saulorios/drone-neuromorfico/docs/caderno.md

# Caderno: decisões, descartes e coisas aprendidas

O `decisoes.md` registra *o que* mudou e *quando*. Este caderno é para o raciocínio mais
longo: alternativas consideradas e por que foram descartadas, intuições que se mostraram
erradas, e perguntas ainda em aberto.

---

## Intuições que se mostraram erradas

### "O capacitor de membrana define a constante de tempo do neurônio"

Falso nesta topologia, e a razão é bonita. Numa membrana biológica, ou num
integrador RC comum, aumentar a capacitância aumenta a constante de tempo. Aqui não.

A membrana precisa percorrer uma janela de histerese `ΔV` que é criada pelo próprio
degrau de realimentação através de `Cfb`. Esse degrau é um divisor capacitivo:
`ΔV = VDD · Cfb / (Cmem + Cfb + parasitas)`. A rampa, por sua vez, sobe a
`Iin / (Cmem + Cfb + parasitas)`.

O tempo de percurso é `ΔV` dividido pela inclinação — e o mesmo `Ctot` aparece no
numerador e no denominador:

```
T = Ctot · ΔV / Iin = Ctot · (VDD · Cfb / Ctot) / Iin = Cfb · VDD / Iin
```

`Cmem` desaparece. Não "quase se cancela": some. Quem manda na frequência é `Cfb`,
`VDD` e `Iin`.

A intuição errada tinha uma consequência de projeto errada junto: supunha-se que o
capacitor de membrana dominaria a área do neurônio no chip. Como ele deve ser pequeno,
a estimativa de área está invertida — o neurônio pode ser mais compacto que o previsto.

**O que `Cmem` de fato controla** é a excursão de sinal, e para pior: 25 fF dá 1,05 V de
excursão, 400 fF dá 0,079 V. Abaixo de ~0,2 V, descasamento entre transistores e ruído
de alimentação passam a dominar o comportamento. `Cmem` grande não compra lentidão;
compra fragilidade.

---

## Alternativas consideradas e descartadas

### Chips especializados por modalidade (um para áudio, outro para visão)

Descartado. Três motivos: (a) o gargalo real do sistema é a comunicação entre chips, e
separar modalidades encarece justamente as associações multissensoriais que se quer ter;
(b) a proporção necessária entre modalidades ainda é desconhecida, e chips fixos travam
essa proporção antes da hora; (c) três máscaras custam três vezes mais que uma.

Escolha adotada: um único chip com neurônios configuráveis por tensões de polarização,
replicado quantas vezes couber no orçamento de peso e energia. A modalidade vira
parâmetro de configuração, não silício. É a mesma escolha feita por Loihi, SpiNNaker e
Akida — o que é um bom sinal, mas não é prova.

Exceção legítima: a interface analógica de sensor (amplificador de microfone,
fotodiodos) é específica por modalidade e não configurável. Vai num chip de interface
pequeno e barato, separado do chip de neurônios homogêneo.

### Re-rodar a etapa 0 com nível 1 para refazer os números de física

Descartado em 2026-09-06. Os modelos nível 1 não descrevem a condução sub-limiar, então
qualquer número refeito com eles teria que ser refeito de novo na etapa 1.

Mas um re-rodar *de numérica* foi mantido: ver a pergunta em aberto sobre `abstol`
abaixo. Ele custa minutos, testa a ferramenta em vez do circuito, e as ressalvas 1 a 3
podem ser artefato de tolerância, não de física.

---

## Perguntas em aberto

- **De onde vem o fator 1,76×?** O modelo `T = Cfb·VDD/Iin` prevê 278 Hz em 10 pA;
  mediu-se 158 Hz. O modelo acerta *todas* as tendências — independência de `Cmem`,
  linearidade em `Iin`, escala com VDD dentro de 3% — e erra só a escala absoluta, o que
  aponta para um fator multiplicativo constante e não para um mecanismo faltando.
  Suspeita: a saída ultrapassa VDD no spike (visível no painel 1, ~1,9 V contra 1,8 V de
  alimentação) e o reset leva a membrana abaixo do ponto de equilíbrio; juntos, alargam
  a janela de histerese real além de `VDD · Cfb / Ctot`. Verificável medindo a janela
  diretamente em vez de inferi-la.

- **A curva f–I é mesmo linear?** Nunca foi testada — o R² era uma string. Com o
  intercepto observado, a reta prevê 181 Hz em 10 pA contra 158 Hz medidos. Ou há
  curvatura real, ou é o ruído numérico de ~10% do item 1 das ressalvas. Os dois casos
  têm consequências diferentes e precisam ser separados.

- **Quanto da frequência é rampa e quanto é reset?** Se o tempo de reset for uma fração
  grande do período, ele impõe um teto de frequência que a curva f–I ainda não alcançou,
  e a linearidade vai quebrar em correntes mais altas que 100 pA.

- **A dependência `f ∝ VDD` é fatal?** Ela é estrutural, não um ajuste ruim: sai direto
  da equação. Se a compensação exigir mudar a topologia (limitar a excursão de saída em
  vez de deixá-la ir de trilho a trilho), é melhor descobrir na etapa 1 do que na 8.

- **As ressalvas da etapa 0 são física ou são `abstol`?** O padrão do ngspice é
  `abstol = 1 pA`, e as simulações rodaram com `Iin` de 1 a 100 pA sem nenhum `.options`.
  No ponto de 1 pA, o sinal inteiro está dentro da tolerância de convergência; no ponto
  nominal de 10 pA, a tolerância é 10% do sinal — a mesma ordem do espalhamento
  observado entre execuções. O `gmin` padrão (1e-12 S) acrescenta mais ~0,9 pA de fuga
  parasita no nó `mem`. É uma explicação única e econômica para as ressalvas 1, 2 e 3,
  e é barata de testar. Enquanto não for testada, continua sendo hipótese: pode ser que
  o espalhamento venha só de `tstep` e a tolerância não tenha nada a ver.

---

## Mecanismo conhecido e disponível, NÃO planejado — inibição lateral (2026-09-09)

**Registrado para não ser redescoberto tarde. Não abrir agora.**

**O que é.** Inibição lateral / *winner-take-all* (Mead, 1989): num grupo de neurônios, o
primeiro a disparar suprime os vizinhos por um intervalo curto. O efeito é **codificação
esparsa** — de N neurônios que poderiam responder a um estímulo, poucos respondem.

**Por que é barato.** É circuito de **poucos transistores compartilhado por grupo**, não uma
célula por neurônio. Não exige sinapse plástica, não exige memória, não exige peso. Numa
malha onde a sinapse custa 383 a 568 µm² (R5), um mecanismo que melhora a representação sem
sinapse nova é economicamente diferente de tudo o mais no projeto.

**Onde ele encaixa.** É a **terceira perna do controle de esquecimento catastrófico**, junto
com duas que já estão no dossiê:

| perna | onde está | o que faz |
|---|---|---|
| modulação por surpresa | dossiê §5.2 | quase nada é gravado — fecha a plasticidade em momentos calmos |
| consolidação em repouso | dossiê §5.1 | integra o aprendido durante o pouso, sem sobrescrever |
| **inibição lateral** | **não planejada** | **codificação esparsa — menos sobreposição entre representações, logo menos interferência entre o que já se sabe e o que se aprende** |

As três atacam o mesmo problema por vias independentes: a primeira controla **quando** se
grava, a segunda **quando se reorganiza**, a terceira **quantos neurônios participam de cada
representação**. Representações esparsas se sobrepõem menos, e sobreposição é o mecanismo do
esquecimento catastrófico.

**Por que NÃO abrir agora.** Vale a regra do projeto: uma pergunta por vez. A etapa 2 (medida
de descasamento) e a decisão de arquitetura aberta pelo R5 vêm antes. Além disso, inibição
lateral só faz sentido depois que houver mais de um neurônio funcionando junto — etapa 4 no
mínimo.

**Não medido, não simulado, não decidido.** É levantamento.

---

## Módulo de perfil de polarização (a analogia do DNA) — 2026-09-09

**Isto é vocabulário, não decisão nova.** Dá nome a algo que o projeto já decidiu duas
vezes, em lugares separados, sem nunca ter chamado de nada.

### A analogia

O DNA cumpre **duas** funções distintas, e confundi-las é o que faz a analogia com hardware
dar errado:

| função do DNA | quando | reversível? |
|---|---|---|
| **constrói** o cérebro no desenvolvimento — quantos neurônios, onde, quem se liga a quem | uma vez | **não** |
| **modula** o que já está construído, regulando expressão | contínua, ao longo da vida | **sim** |

No chip:

| função | o que é | quando |
|---|---|---|
| construir | **o tapeout** | uma vez. A fiação é metal e não muda depois de fabricada |
| modular | **as tensões de polarização** | a qualquer momento, de fora |

As tensões de polarização não mudam fiação. Mudam **quanto cada parte responde** —
constante de tempo, limiar, corrente de repouso, taxa de plasticidade.

### A consequência de organização, que é o registro que importa

Um **módulo externo de perfis** é a forma correta de organizar isso: uma memória digital
guardando **conjuntos nomeados** de valores de polarização, mais conversores
digital-analógico que os aplicam ao chip. Perfil "áudio", perfil "presença", perfil
"associação". **Trocar o perfil muda o comportamento do chip sem refabricar nada.**

### Por que isto não é decisão nova

É a soma de duas decisões que já existiam e nunca haviam sido postas lado a lado:

| decisão existente | onde está |
|---|---|
| um chip homogêneo replicado; a modalidade vira **parâmetro de configuração, não silício** | dossiê §5.4, e acima em "Chips especializados por modalidade" |
| toda polarização que define constante de tempo, limiar ou corrente deve ser **acessível externamente** | `CLAUDE.md` §6, decisão de 2026-09 |

**O soquete já tinha sido projetado; faltava o nome.** Nenhuma das duas linhas foi alterada
— esta entrada aponta para elas.

### O LIMITE, e sem ele a analogia engana

Registrado junto de propósito. O módulo de perfis **não pode**:

- **ativar neurônios específicos** — não há como "ligar o neurônio 47 e desligar o 48"
  por polarização; a polarização é global ou por bloco;
- **escolher quem se liga a quem DENTRO do neurônio** — isso é fiação, fixada no tapeout.

O que ele **pode**:

- ajustar o **comportamento** de todos os neurônios (as grandezas da tabela acima);
- **reconfigurar quem conversa com quem ENTRE neurônios** — via tabela de roteamento AER,
  que é digital e reprogramável (ver `etapas.md`, etapa 6).

A analogia com o DNA é boa para separar "construir" de "modular". Ela é **ruim** se levar a
pensar que o perfil pode reorganizar a rede: o DNA constrói fiação nova durante o
desenvolvimento, e o chip não tem desenvolvimento. Depois do tapeout, só a tabela AER se
mexe.
