saulorios/drone-neuromorfico/resultados/2026-09-06_starving/starving_resultados.png

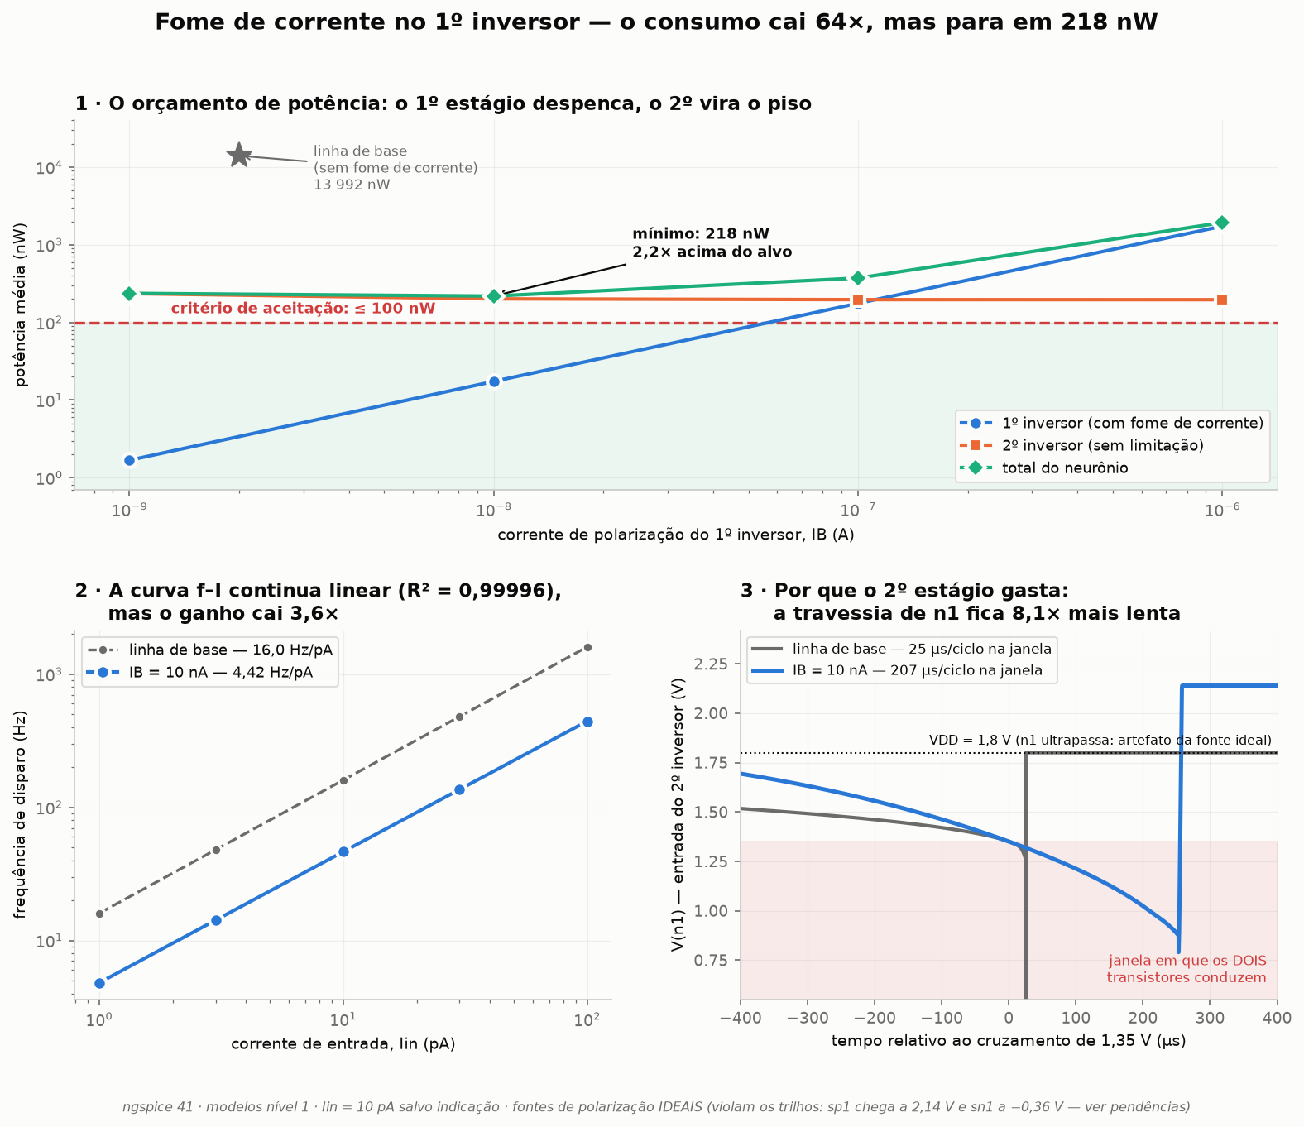
resultados/2026-09-06_starving/starving_resultados.png
