saulorios/drone-neuromorfico/resultados/2026-09-06_starving_conformidade/validacao_testbench.png

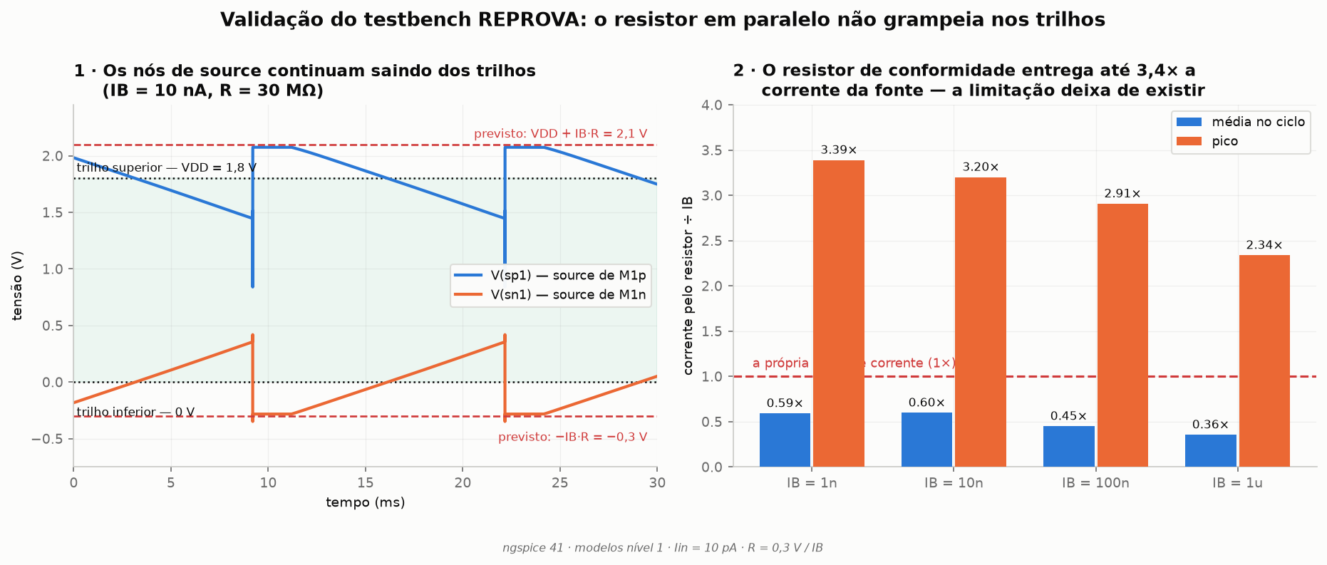
resultados/2026-09-06_starving_conformidade/validacao_testbench.png
