saulorios/drone-neuromorfico/resultados/2026-09-07_cmem_sky130/cmem_sky130.png

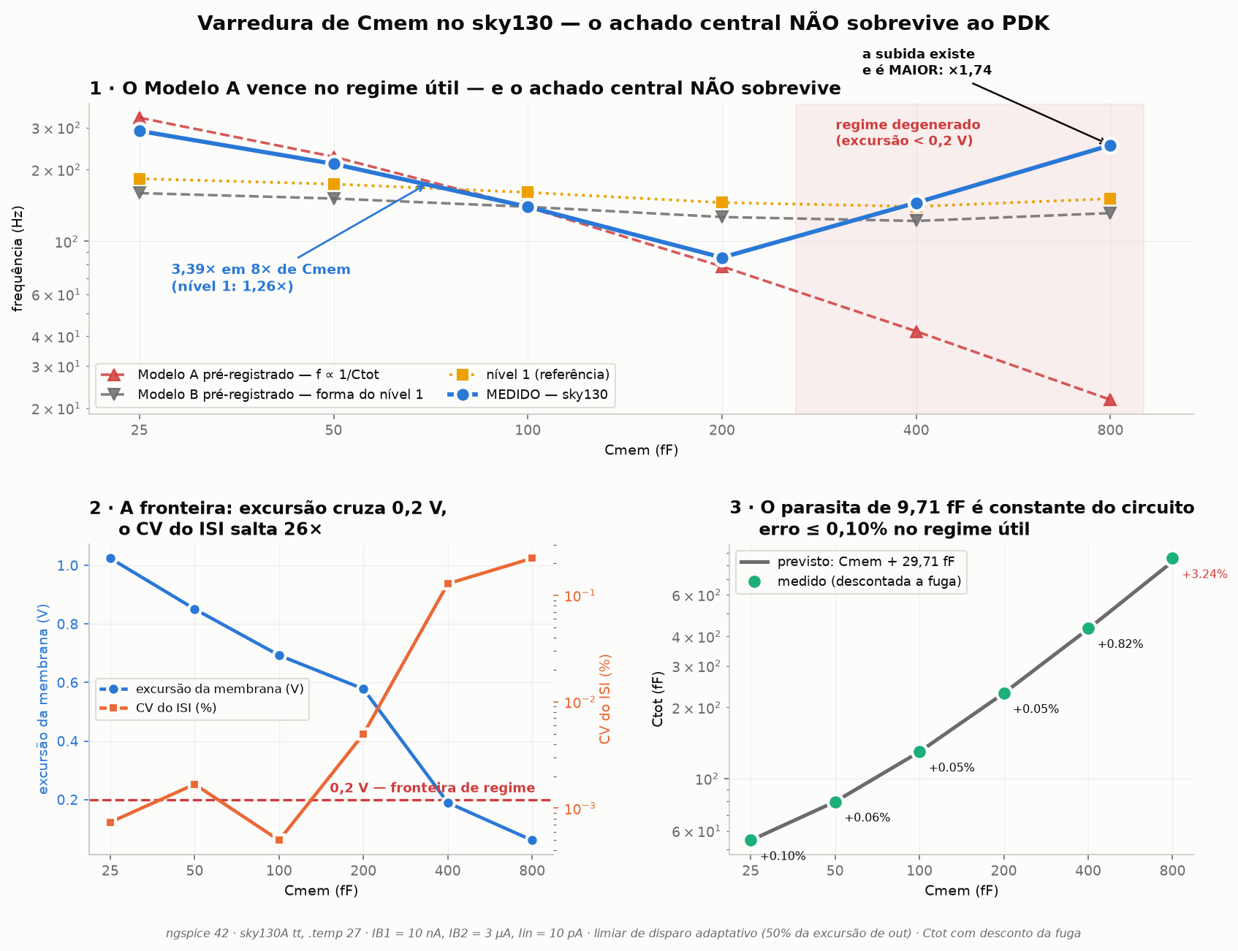
resultados/2026-09-07_cmem_sky130/cmem_sky130.png
