saulorios/drone-neuromorfico/resultados/2026-09-07_etapa1_pdk/validacao_pdk.png

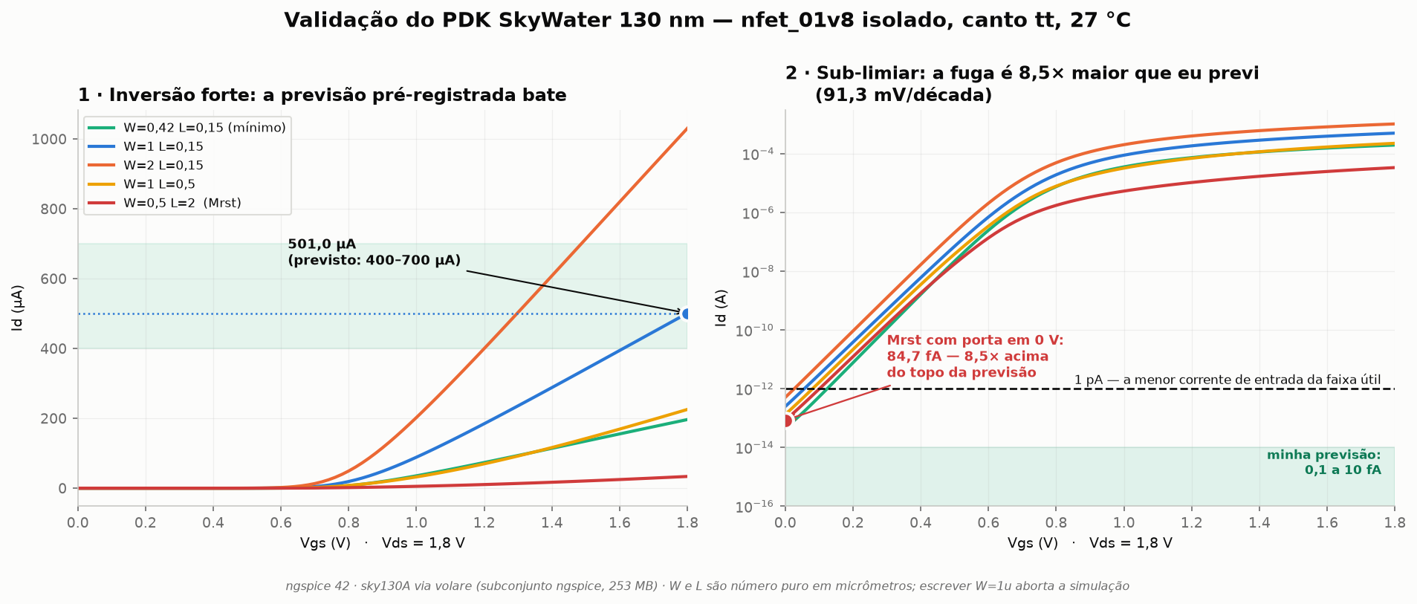
resultados/2026-09-07_etapa1_pdk/validacao_pdk.png
