saulorios/drone-neuromorfico/resultados/2026-09-07_fi_espelho/fi_espelho.png

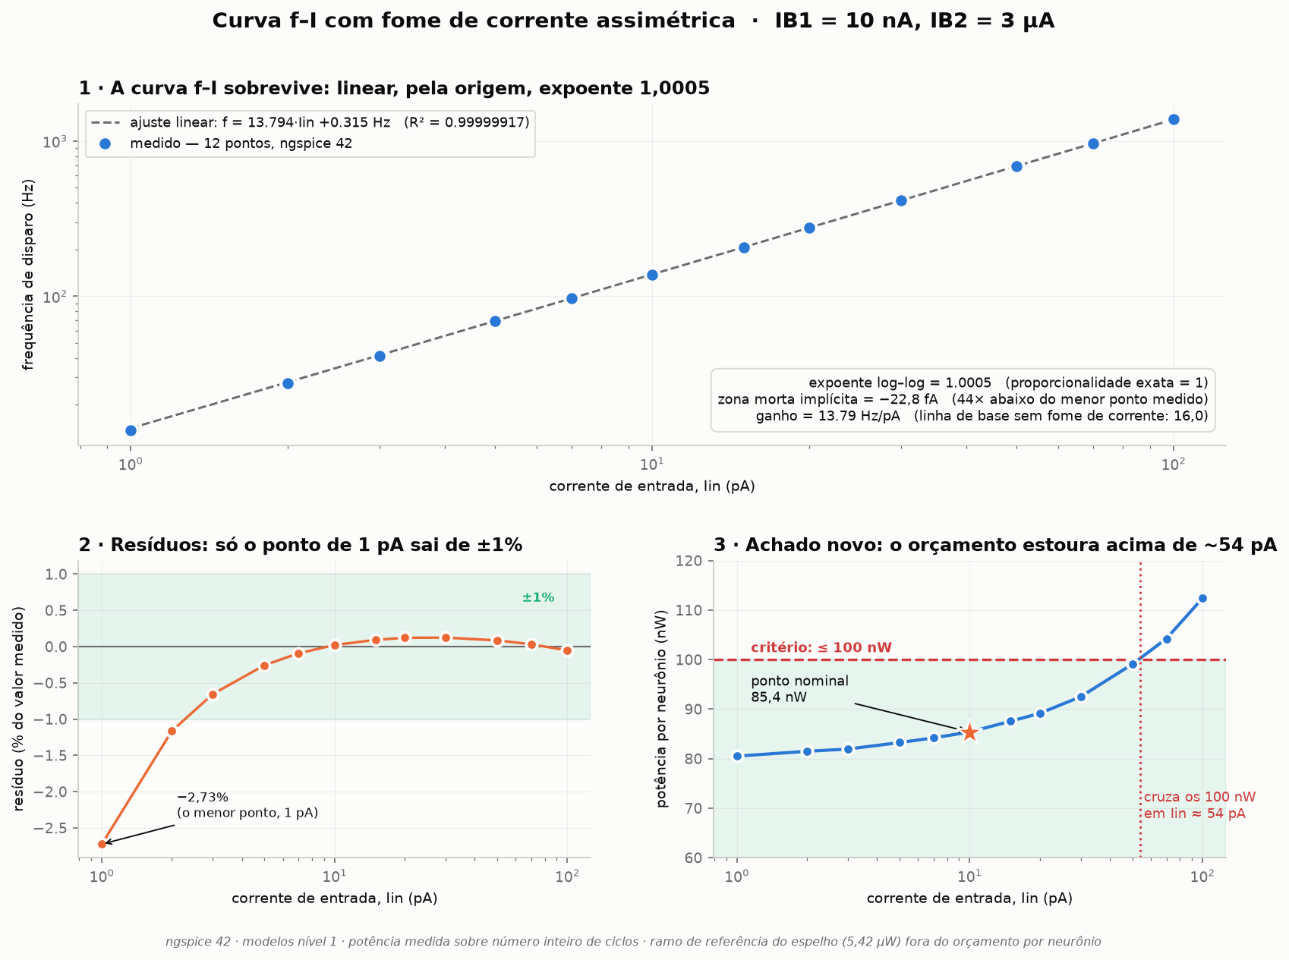
resultados/2026-09-07_fi_espelho/fi_espelho.png
