saulorios/drone-neuromorfico/resultados/2026-09-07_fuga_mem/fuga_mem.png

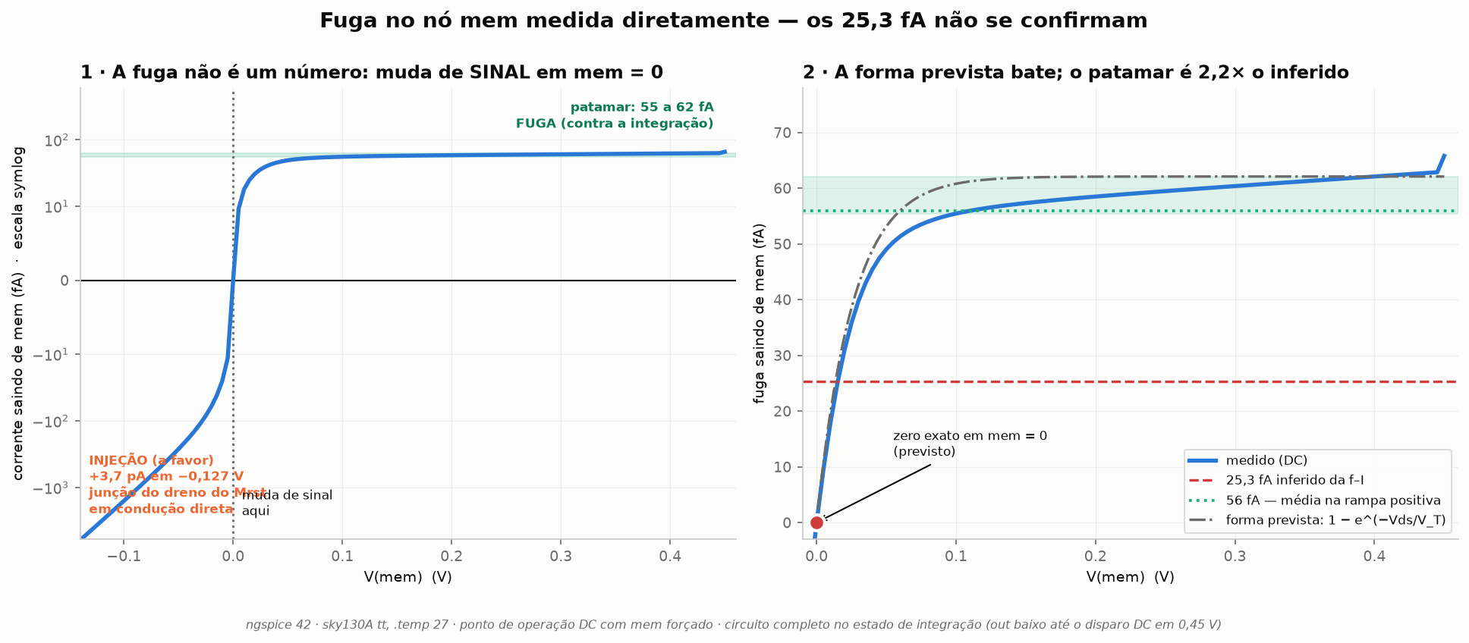
resultados/2026-09-07_fuga_mem/fuga_mem.png
