saulorios/drone-neuromorfico/resultados/2026-09-07_histerese/histerese.png

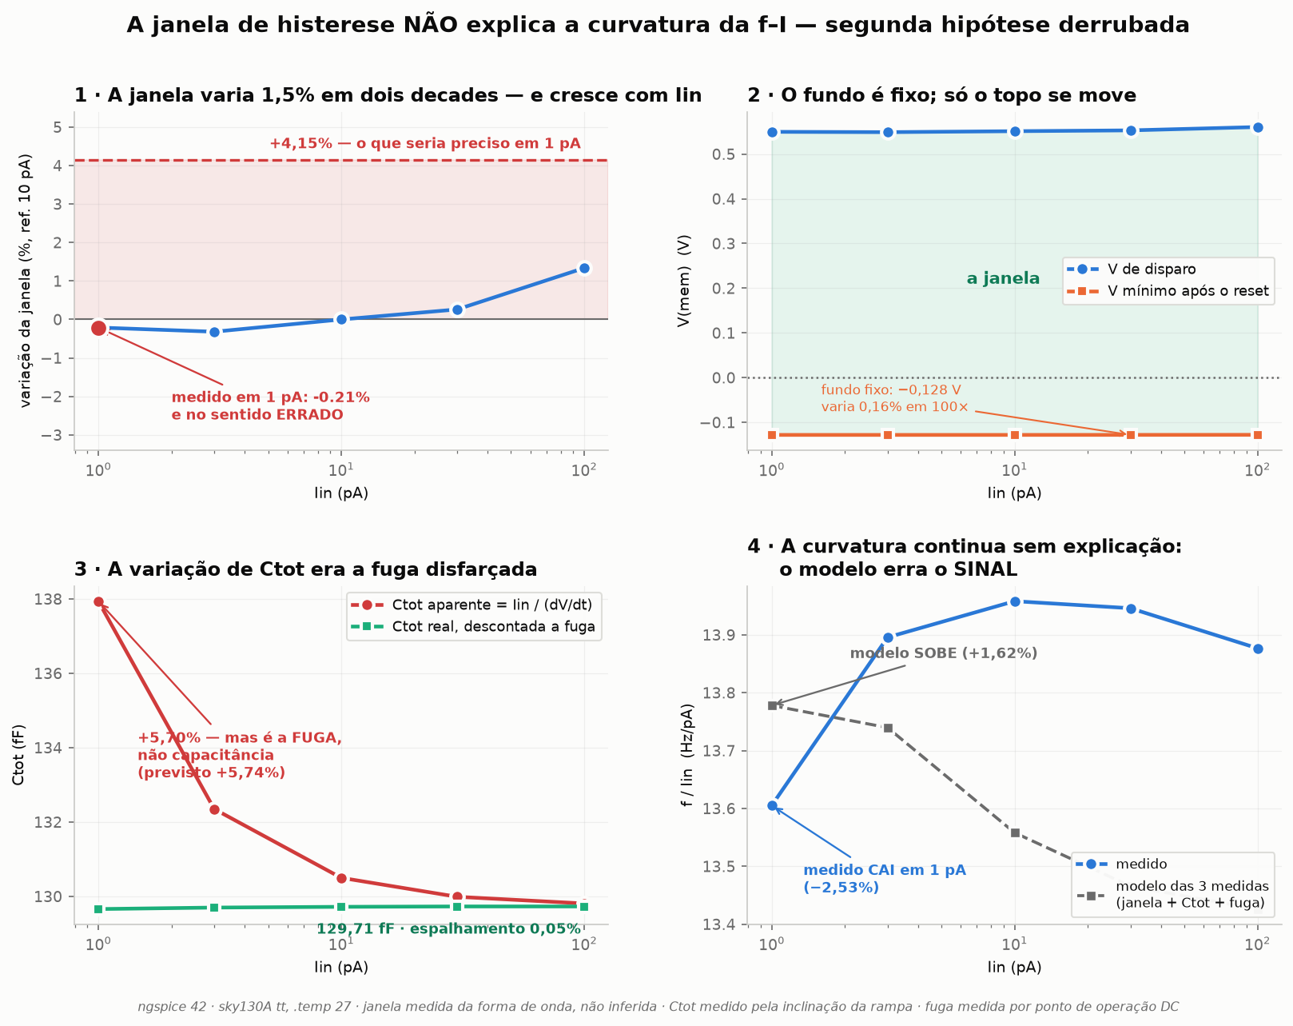
resultados/2026-09-07_histerese/histerese.png
