saulorios/drone-neuromorfico/resultados/2026-09-07_migracao_sky130/migracao_sky130.png

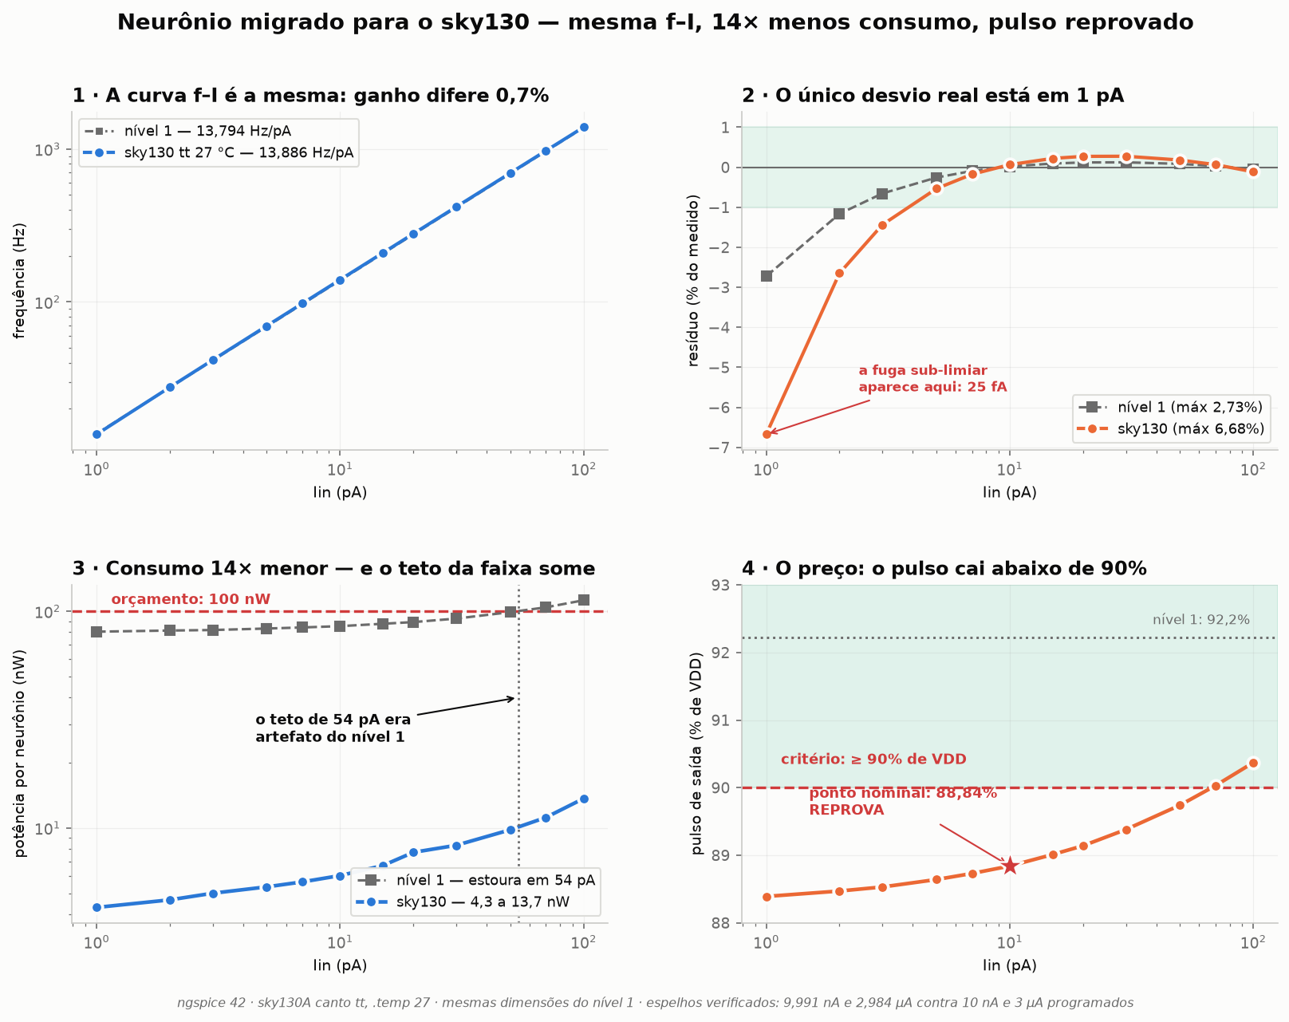
resultados/2026-09-07_migracao_sky130/migracao_sky130.png
