saulorios/drone-neuromorfico/resultados/2026-09-07_receptor/receptor.png

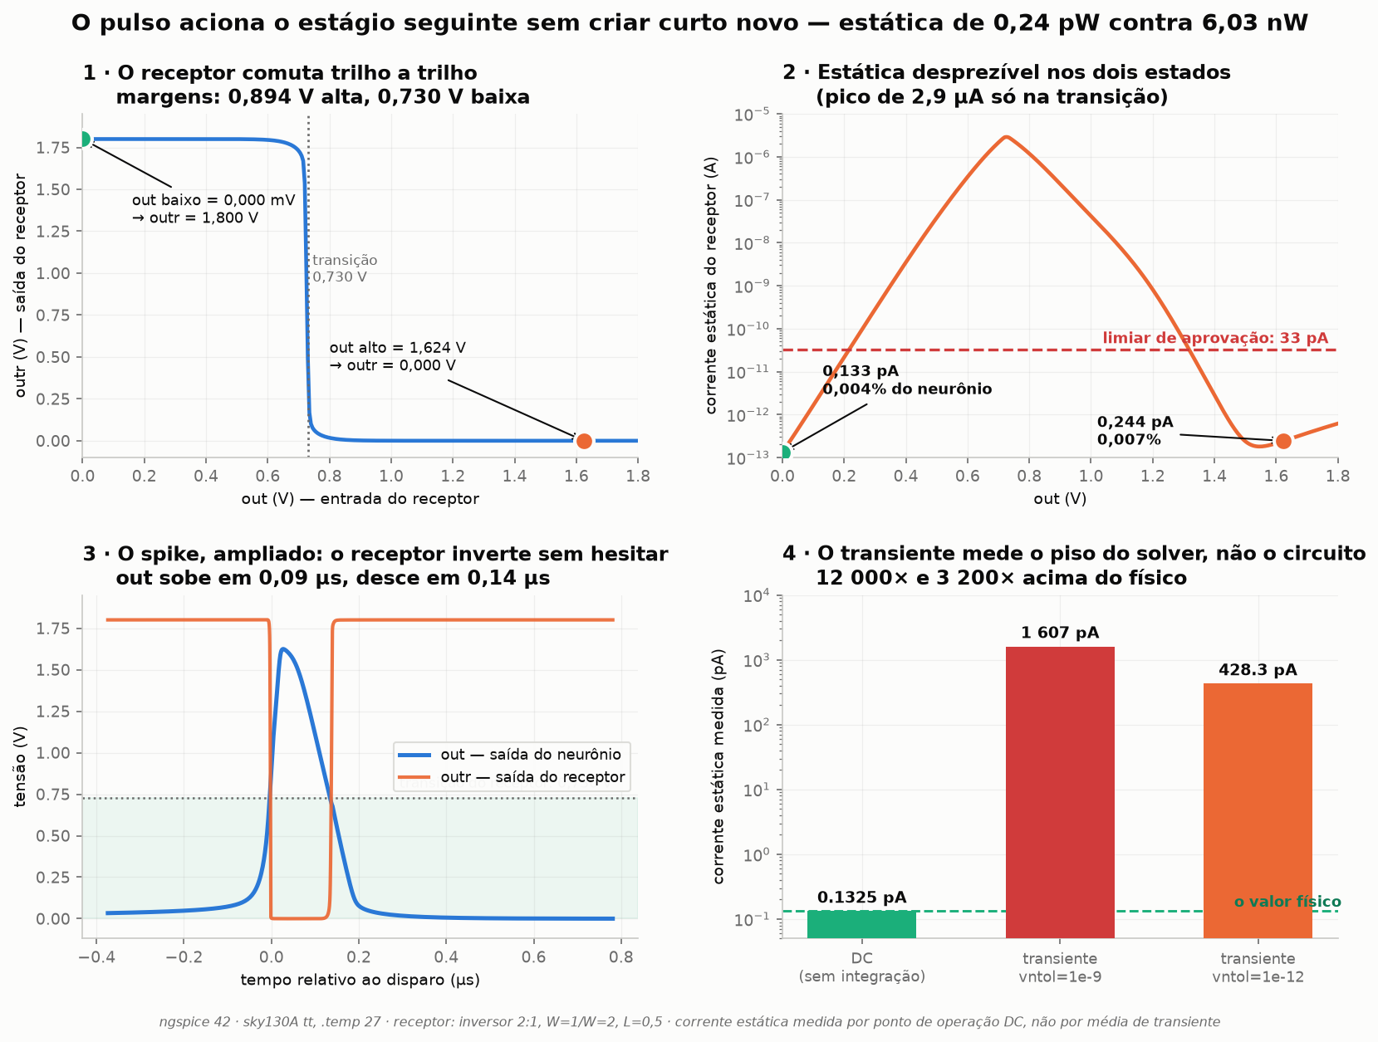
resultados/2026-09-07_receptor/receptor.png
