saulorios/drone-neuromorfico/resultados/2026-09-08_etapa2_instrumento/instrumento.png

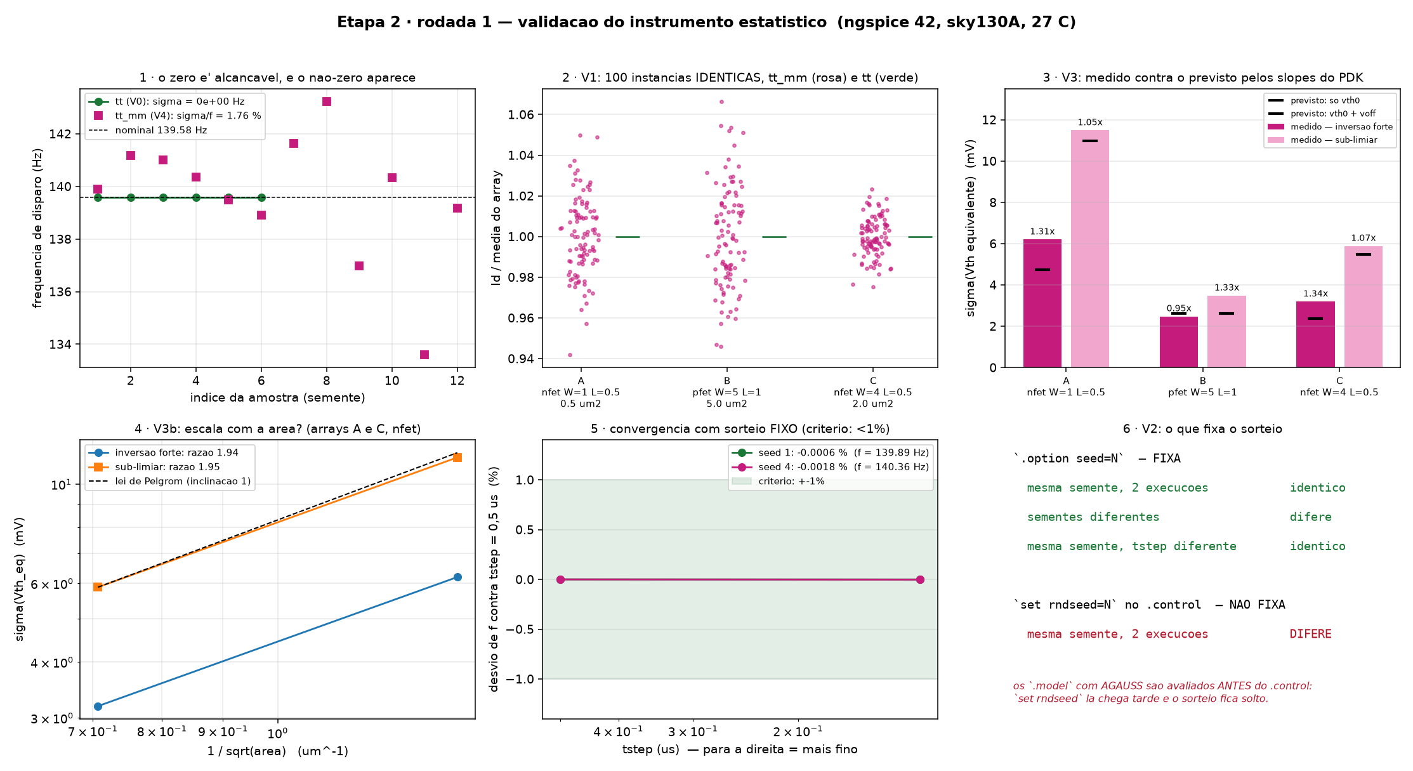
resultados/2026-09-08_etapa2_instrumento/instrumento.png
