saulorios/drone-neuromorfico/resultados/2026-09-08_etapa2_instrumento/raw/v1_mm_vgsa.cir

* v1_mm_vgsa - arrays de dispositivos identicos, canto tt_mm, vgs=1.2, rndseed=1
.lib spice/models/sky130/sky130A/libs.tech/ngspice/sky130.lib.spice tt_mm
.temp 27

Vg  g  0 1.2
Vd  d  0 1.8
Vgp gp 0 0.6000000000000001
Vdp dp 0 0
Vsp sp 0 1.8

Vma0 da0 d 0
XA0 da0 g 0 0 sky130_fd_pr__nfet_01v8 W=1 L=0.5
Vma1 da1 d 0
XA1 da1 g 0 0 sky130_fd_pr__nfet_01v8 W=1 L=0.5
Vma2 da2 d 0
XA2 da2 g 0 0 sky130_fd_pr__nfet_01v8 W=1 L=0.5
Vma3 da3 d 0
XA3 da3 g 0 0 sky130_fd_pr__nfet_01v8 W=1 L=0.5
Vma4 da4 d 0
XA4 da4 g 0 0 sky130_fd_pr__nfet_01v8 W=1 L=0.5
Vma5 da5 d 0
XA5 da5 g 0 0 sky130_fd_pr__nfet_01v8 W=1 L=0.5
Vma6 da6 d 0
XA6 da6 g 0 0 sky130_fd_pr__nfet_01v8 W=1 L=0.5
Vma7 da7 d 0
XA7 da7 g 0 0 sky130_fd_pr__nfet_01v8 W=1 L=0.5
Vma8 da8 d 0
XA8 da8 g 0 0 sky130_fd_pr__nfet_01v8 W=1 L=0.5
Vma9 da9 d 0
XA9 da9 g 0 0 sky130_fd_pr__nfet_01v8 W=1 L=0.5
Vma10 da10 d 0
XA10 da10 g 0 0 sky130_fd_pr__nfet_01v8 W=1 L=0.5
Vma11 da11 d 0
XA11 da11 g 0 0 sky130_fd_pr__nfet_01v8 W=1 L=0.5
Vma12 da12 d 0
XA12 da12 g 0 0 sky130_fd_pr__nfet_01v8 W=1 L=0.5
Vma13 da13 d 0
XA13 da13 g 0 0 sky130_fd_pr__nfet_01v8 W=1 L=0.5
Vma14 da14 d 0
XA14 da14 g 0 0 sky130_fd_pr__nfet_01v8 W=1 L=0.5
Vma15 da15 d 0
XA15 da15 g 0 0 sky130_fd_pr__nfet_01v8 W=1 L=0.5
Vma16 da16 d 0
XA16 da16 g 0 0 sky130_fd_pr__nfet_01v8 W=1 L=0.5
Vma17 da17 d 0
XA17 da17 g 0 0 sky130_fd_pr__nfet_01v8 W=1 L=0.5
Vma18 da18 d 0
XA18 da18 g 0 0 sky130_fd_pr__nfet_01v8 W=1 L=0.5
Vma19 da19 d 0
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
Vmc96 dc96 d 0
XC96 dc96 g 0 0 sky130_fd_pr__nfet_01v8 W=4 L=0.5
Vmc97 dc97 d 0
XC97 dc97 g 0 0 sky130_fd_pr__nfet_01v8 W=4 L=0.5
Vmc98 dc98 d 0
XC98 dc98 g 0 0 sky130_fd_pr__nfet_01v8 W=4 L=0.5
Vmc99 dc99 d 0
XC99 dc99 g 0 0 sky130_fd_pr__nfet_01v8 W=4 L=0.5

.options abstol=1e-15 vntol=1e-9 reltol=1e-4 gmin=1e-15 chgtol=1e-16
+ trtol=1
.control
set rndseed=1
set filetype=ascii
op
let out = vector(0)
wrdata resultados/2026-09-08_etapa2_instrumento/raw/v1_mm_vgsa.txt i(Vma0) i(Vma1) i(Vma2) i(Vma3) i(Vma4) i(Vma5) i(Vma6) i(Vma7) i(Vma8) i(Vma9) i(Vma10) i(Vma11) i(Vma12) i(Vma13) i(Vma14) i(Vma15) i(Vma16) i(Vma17) i(Vma18) i(Vma19) i(Vma20) i(Vma21) i(Vma22) i(Vma23) i(Vma24) i(Vma25) i(Vma26) i(Vma27) i(Vma28) i(Vma29) i(Vma30) i(Vma31) i(Vma32) i(Vma33) i(Vma34) i(Vma35) i(Vma36) i(Vma37) i(Vma38) i(Vma39) i(Vma40) i(Vma41) i(Vma42) i(Vma43) i(Vma44) i(Vma45) i(Vma46) i(Vma47) i(Vma48) i(Vma49) i(Vma50) i(Vma51) i(Vma52) i(Vma53) i(Vma54) i(Vma55) i(Vma56) i(Vma57) i(Vma58) i(Vma59) i(Vma60) i(Vma61) i(Vma62) i(Vma63) i(Vma64) i(Vma65) i(Vma66) i(Vma67) i(Vma68) i(Vma69) i(Vma70) i(Vma71) i(Vma72) i(Vma73) i(Vma74) i(Vma75) i(Vma76) i(Vma77) i(Vma78) i(Vma79) i(Vma80) i(Vma81) i(Vma82) i(Vma83) i(Vma84) i(Vma85) i(Vma86) i(Vma87) i(Vma88) i(Vma89) i(Vma90) i(Vma91) i(Vma92) i(Vma93) i(Vma94) i(Vma95) i(Vma96) i(Vma97) i(Vma98) i(Vma99) i(Vmb0) i(Vmb1) i(Vmb2) i(Vmb3) i(Vmb4) i(Vmb5) i(Vmb6) i(Vmb7) i(Vmb8) i(Vmb9) i(Vmb10) i(Vmb11) i(Vmb12) i(Vmb13) i(Vmb14) i(Vmb15) i(Vmb16) i(Vmb17) i(Vmb18) i(Vmb19) i(Vmb20) i(Vmb21) i(Vmb22) i(Vmb23) i(Vmb24) i(Vmb25) i(Vmb26) i(Vmb27) i(Vmb28) i(Vmb29) i(Vmb30) i(Vmb31) i(Vmb32) i(Vmb33) i(Vmb34) i(Vmb35) i(Vmb36) i(Vmb37) i(Vmb38) i(Vmb39) i(Vmb40) i(Vmb41) i(Vmb42) i(Vmb43) i(Vmb44) i(Vmb45) i(Vmb46) i(Vmb47) i(Vmb48) i(Vmb49) i(Vmb50) i(Vmb51) i(Vmb52) i(Vmb53) i(Vmb54) i(Vmb55) i(Vmb56) i(Vmb57) i(Vmb58) i(Vmb59) i(Vmb60) i(Vmb61) i(Vmb62) i(Vmb63) i(Vmb64) i(Vmb65) i(Vmb66) i(Vmb67) i(Vmb68) i(Vmb69) i(Vmb70) i(Vmb71) i(Vmb72) i(Vmb73) i(Vmb74) i(Vmb75) i(Vmb76) i(Vmb77) i(Vmb78) i(Vmb79) i(Vmb80) i(Vmb81) i(Vmb82) i(Vmb83) i(Vmb84) i(Vmb85) i(Vmb86) i(Vmb87) i(Vmb88) i(Vmb89) i(Vmb90) i(Vmb91) i(Vmb92) i(Vmb93) i(Vmb94) i(Vmb95) i(Vmb96) i(Vmb97) i(Vmb98) i(Vmb99) i(Vmc0) i(Vmc1) i(Vmc2) i(Vmc3) i(Vmc4) i(Vmc5) i(Vmc6) i(Vmc7) i(Vmc8) i(Vmc9) i(Vmc10) i(Vmc11) i(Vmc12) i(Vmc13) i(Vmc14) i(Vmc15) i(Vmc16) i(Vmc17) i(Vmc18) i(Vmc19) i(Vmc20) i(Vmc21) i(Vmc22) i(Vmc23) i(Vmc24) i(Vmc25) i(Vmc26) i(Vmc27) i(Vmc28) i(Vmc29) i(Vmc30) i(Vmc31) i(Vmc32) i(Vmc33) i(Vmc34) i(Vmc35) i(Vmc36) i(Vmc37) i(Vmc38) i(Vmc39) i(Vmc40) i(Vmc41) i(Vmc42) i(Vmc43) i(Vmc44) i(Vmc45) i(Vmc46) i(Vmc47) i(Vmc48) i(Vmc49) i(Vmc50) i(Vmc51) i(Vmc52) i(Vmc53) i(Vmc54) i(Vmc55) i(Vmc56) i(Vmc57) i(Vmc58) i(Vmc59) i(Vmc60) i(Vmc61) i(Vmc62) i(Vmc63) i(Vmc64) i(Vmc65) i(Vmc66) i(Vmc67) i(Vmc68) i(Vmc69) i(Vmc70) i(Vmc71) i(Vmc72) i(Vmc73) i(Vmc74) i(Vmc75) i(Vmc76) i(Vmc77) i(Vmc78) i(Vmc79) i(Vmc80) i(Vmc81) i(Vmc82) i(Vmc83) i(Vmc84) i(Vmc85) i(Vmc86) i(Vmc87) i(Vmc88) i(Vmc89) i(Vmc90) i(Vmc91) i(Vmc92) i(Vmc93) i(Vmc94) i(Vmc95) i(Vmc96) i(Vmc97) i(Vmc98) i(Vmc99)
.endc
.end
