saulorios/drone-neuromorfico/(commit log)

2026-09-07 Estado inicial: estrutura de pastas, CLAUDE.md e resultados da etapa 0
    Primeiro commit do repositorio. Registra o estado tal como esta antes de
    qualquer integracao da revalidacao, para que os diffs seguintes sejam legiveis.
    Conteudo:
    - Estrutura de pastas conforme a Parte 9.2 do dossie (docs/, spice/, scripts/,
    resultados/, fpga/).
    - CLAUDE.md conforme a Parte 9.3, com as duas regras do projeto, os numeros da
    etapa 0 com denominador, e as ressalvas abertas sobre esses numeros.
    - docs/caderno.md e docs/decisoes.md.
    - Netlist do neuronio axon-hillock e modelos nivel 1 extraidos para arquivo
    proprio, sem duplicacao.
    - Scripts de simulacao e de graficos, com os caminhos absolutos /home/cl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
2026-09-07 Integra revalidacao da etapa 0 e bloco .options no netlist
    Passos 2 e 3 da tarefa de registro. Apenas arquivos; a memoria do projeto
    (CLAUDE.md, decisoes.md) e atualizada no commit seguinte.
    - resultados/2026-09-06_revalidacao_etapa0/revalidacao.md: relatorio da
    revalidacao executada fora deste ambiente, com ngspice 42 e os modelos
    nivel 1 inalterados.
    - spice/neuronio.cir: acrescentado o bloco .options de tolerancia apos o
    .include dos modelos. Diff conferido: essa e a unica diferenca, nenhuma
    alteracao de circuito.
    .options abstol=1e-15 vntol=1e-9 reltol=1e-4 gmin=1e-15 chgtol=1e-16
    + trtol=1
    Motivo: o abstol padrao do ngspice e 1e-12 A = 1 pA, da mesma ordem do sinal
    de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
2026-09-07 Corrige a memoria do projeto com os numeros revalidados
    Passos 4 a 7 da tarefa de registro. Os numeros anteriores nao foram
    corrigidos: foram descartados, porque produzidos com tolerancias padrao.
    CLAUDE.md:
    - §2: etapa 0 marcada como revalidada; registrado que a revalidacao tambem
    rodou fora deste ambiente.
    - §3: "Cmem cancela exatamente / some da equacao" substituido por "Cmem e um
    controle fraco, com residuo medido de 24% em 16x". Corrigido tambem o
    impacto na area: Cfb fixa a frequencia e nao pode encolher, entao a area
    segue dominada por um capacitor.
    - §4: 160,3 Hz no ponto nominal; ganho 16,0 Hz/pA; sem zona morta ate 1 pA;
    12,6 uW por neuronio (7e5 vezes a potencia do s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
2026-09-07 Fome de corrente no 1o inversor: falha o criterio de 100 nW
    Pergunta: limitar a corrente do 1o inversor reduz o consumo para <= 100 nW sem
    destruir a curva f-I?
    RESPOSTA: NAO. Melhor ponto (IB = 10 nA) da 218,3 nW, 2,2x acima do criterio.
    Criterios, um a um:
    - Potencia <= 100 nW ............ REPROVA: 218,3 nW
    - CV do ISI < 0,1% ............... aprova: 0,0043%
    - Pulso de saida >= 90% de VDD ... aprova raspando: 1,623 V = 90,2% (margem 3 mV)
    - f-I linear pela origem ......... aprova: R2 = 0,999956, sem zona morta
    mas o ganho cai 3,6x: 16,0 -> 4,42 Hz/pA, e a frequencia cai 160,3 -> 46,3 Hz
    O conceito funciona no estagio em que foi aplicado: o 1o inversor cai de 12 702
    para 1,68 nW (fator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
2026-09-07 Testbench com conformidade finita REPROVA a validacao; sweeps nao executados
    O resistor em paralelo com a fonte de corrente nao grampeia nos trilhos. Como
    o criterio de validacao era para ser conferido ANTES de olhar potencia, parei
    antes dos sweeps 1 e 2. A pergunta dos 100 nW segue sem resposta validada.
    Medido (Iin = 10 pA, tstep = 0,5 us, R = 0,3 V / IB):
    IB sp1 max sn1 min n1 f
    1n 2,039 V -0,350 V 0,829..2,039 79,37 Hz
    10n 2,075 V -0,349 V 0,840..2,075 77,13 Hz
    100n 1,992 V -0,237 V 0,862..1,992 109,51 Hz
    1u 1,954 V -0,192 V 0,833..1,952 127,97 Hz
    Exigido: sp1 <= 1,8 V, sn1 >= 0 V, n1 de volta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
2026-09-07 Registra o resultado do espelho: consumo resolvido, topologia confirmada
    PARTE A da tarefa (registro). Fonte: resultados/2026-09-06_espelho/espelho.md,
    ngspice 42, modelos nivel 1 inalterados.
    O consumo de 12,6 uW por neuronio, que era a ressalva bloqueante da §5-A, caiu
    para 83,5 nW: reducao de 151x. Energia por disparo 78 nJ -> 0,60 nJ. Decisao do
    autor do projeto: a topologia axon-hillock FICA.
    Arquivos:
    - resultados/2026-09-06_espelho/espelho.md
    - resultados/2026-09-06_espelho/raw/mirror.cir (netlist base, fome simetrica).
    O .include foi padronizado para caminho relativo a raiz, conforme CLAUDE.md §9.
    - §2: etapa 0 com consumo resolvido, deixa de ter ressalva bloqueant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
2026-09-07 Curva f-I no ponto do espelho: SOBREVIVE. Fecha as pendencias 1 e 2
    PARTE B da tarefa. Pergunta: a curva f-I sobrevive em IB1 = 10 nA, IB2 = 3 uA?
    RESPOSTA: sim, com folga.
    ajuste linear, intercepto livre : f = 13,79354*Iin + 0,3145 Hz
    R2 ............................. 0,99999917
    ajuste log-log ................. expoente 1,00054 (exato = 1, desvio 0,05%)
    zona morta implicita ........... -22,8 fA, isto e, nenhuma; 44x abaixo do
    menor ponto medido (1 pA)
    residuo maximo ................. -2,73% no ponto de 1 pA; os outros 11
    dentro de +-1,17%
    convergencia ................... f invariante em 0,002% sobre 16x em ts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
2026-09-07 Registra faixa util, leitura estatico-vs-dinamico, e pre-registra previsoes
    REGISTRO (decisao do Saulo):
    - §4: faixa de validade do orcamento = Iin de 1 a 50 pA (f de 14 a 690 Hz).
    Nessa faixa a potencia vai de 80,5 a 99,1 nW. Acima, fora de validade.
    - §6: decisao datada 2026-09-07. Em vez de afrouxar o alvo de potencia ou
    buscar outro ponto de polarizacao, limita-se a faixa. Custo registrado: a
    faixa util encolhe de dois decades para 1,7 e o teto de frequencia cai de
    1,38 kHz para 690 Hz.
    - §5: observacao de leitura. Dos 85,4 nW do ponto nominal, 80,9 nW sao piso
    estatico e 4,5 nW acompanham a atividade — 5,2% do total. Ajuste na faixa
    util: P = 0,406*Iin + 80,9 nW. Em 1 p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
2026-09-07 Etapa 1 iniciada: PDK sky130 instalado, transistor isolado validado
    REGISTRO da rodada anterior ja foi no commit a0ffaf6. Esta e a etapa 1.
    INSTALACAO ENXUTA, medida antes de baixar. Dos assets do volare, so os dois que
    contem o que o ngspice consome: common (16,6 MB, traz libs.tech/ngspice/) e
    sky130_fd_pr (14,0 MB, traz libs.ref/sky130_fd_pr/spice/). Fora: 166,7 MB de
    celulas padrao, 54,2 de HVL, 50,7 de I/O, 30,3 de SRAM. Baixados 30,6 MB
    comprimidos contra ~380 MB do conjunto completo. sky130B (ReRAM) removido apos
    extrair. Ocupacao final 127 MB, fora do versionamento.
    A ARMADILHA DO W/L: existe, mas e fail-stop e nao fail-silent.
    W=1u L=0.15u -> l=1.5e-07 w=1.0e-06 entregues ao b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
2026-09-07 Corrige o ramo de referencia, da procedencia ao numero da membrana, registra a tesoura e a pergunta da faixa termica
    - Ramo de referencia corrigido para 198 nW e N >= 14, com a conta explicita
    ((10 nA + 100 nA) x 1,8 V; 198 nW / 14,6 nW de folga por neuronio). A
    estimativa anterior de 216 nW e N ~ 15 contava um espelho de NMOS que a
    variante assimetrica eliminou — a fome e so no PMOS. Registrado como erro do
    autor do projeto, nao como divergencia de conta.
    - "membrana opera de -0,11 a 0,56 V" ganhou procedencia: vem de
    resultados/2026-09-07_fi_espelho/, ponto nominal (IB1 = 10 nA, IB2 = 3 uA,
    Iin = 10 pA), com modelos NIVEL 1, nao com o sky130. O neuronio ainda nao foi
    migra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
2026-09-07 Pre-registra as previsoes da migracao do neuronio para o sky130
    Antes de rodar. Escolhi NAO mudar nenhuma dimensao, e o motivo esta no arquivo:
    a pergunta e uma comparacao, e so tem resposta se uma coisa mudar entre as duas
    simulacoes — o modelo do dispositivo. Todas as sete dimensoes sao legais no
    sky130. Alem disso L=0,5 um (3,3x o minimo) e defensavel por merito proprio:
    os dois riscos dominantes sao descasamento e fuga termica, e canal mais longo
    melhora os dois; canal minimo compra velocidade, que um circuito de centenas de
    hertz nao precisa. Fica registrado que L=0,5 continua nao-otimizado.
    Previsoes (nominal: IB1=10 nA, IB2=3 uA, Iin=10 pA, tt, 27 C):
    frequencia ..... 60 a 200 Hz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
2026-09-07 Neuronio migrado para o sky130: f-I reproduz, consumo cai 14x, pulso reprova
    Pergunta: o neuronio migrado reproduz o comportamento do nivel 1?
    Resposta: na funcao de transferencia sim, quase exatamente. No consumo nao — e
    14x menor. E o pulso de saida reprova o criterio de 90%.
    DISCRIMINADOR, antes de olhar comportamento. Espelhos com o dreno forcado a
    0,9 V (saturacao garantida):
    Mbp1: programado 10 nA, entregue 9,9906 nA -> erro 0,09%
    Mbp2: programado 3 uA, entregue 2,9839 uA -> erro 0,54%
    O criterio pre-registrado admitia 2x. Somado a trilhos respeitados nos 12
    pontos, isso fecha: a migracao NAO falhou, o circuito mudou.
    Um criterio meu estava errado: eu havia pre-registrado qu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
2026-09-07 Revoga o criterio de 90%, reverte a faixa util, atualiza a tesoura e o consumo
    1. Criterio do pulso REVOGADO e substituido por criterio funcional no §7. A
    fracao de 90% de VDD foi arbitrada sem base fisica. O pulso passa a ser
    julgado por tres testes: chutar Cfb (o que importa e a EXCURSAO, nao o nivel
    absoluto), abrir o gate do Mrst a ponto de completar o reset, e ser lido como
    nivel alto pelo estagio seguinte com margem e sem criar corrente estatica
    apreciavel. Um pulso que faz as tres coisas esta aprovado, tenha 88% ou 95%.
    Registrado que o gatilho de parada disparou por criterio mal formulado e nao
    por falha do circuito.
    2. Licao de metodo no §7: criterio pre-regi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
2026-09-07 Pre-registra as previsoes do experimento do receptor
    Sem ancorar em nenhuma constante do nivel 1: toda previsao se apoia ou em
    grandeza ja medida no sky130, ou em raciocinio de topologia.
    Receptor: inversor 2:1 (W=1 L=0,5 no NMOS, W=2 L=0,5 no PMOS), alimentacao
    propria vddL para medir sua corrente separada. Razao 2:1 nao centra o ponto de
    transicao em VDD/2 — deixa o NMOS mais forte e o ponto abaixo da metade, o que
    e favoravel aqui porque out fica parado em BAIXO a maior parte do tempo e sobra
    margem para o nivel alto, que e o nivel sob suspeita. L = 0,5 um porque a
    grandeza medida e corrente estatica, e canal minimo inflaria artificialmente o
    proprio numero que se quer medir.
    Previsoe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
2026-09-07 O pulso aciona o estagio seguinte sem criar curto novo: APROVA por ~135x
    Pergunta: o pulso serve para acionar o estagio seguinte sem criar curto novo?
    Resposta: SIM.
    O NUMERO QUE FALTAVA: out baixo = 0,000 mV, o trilho. Previsao era 0 a 5 mV,
    confirmada. O raciocinio se sustentou: n1 alcanca 1,800 V, logo Vsg(M2p) = 0 e
    o PMOS desliga sem ambiguidade.
    CORRENTE ESTATICA do receptor, medida por ponto de operacao DC:
    out parado em BAIXO (0,0000 V) : 0,1325 pA -> 0,239 pW -> 0,004% dos 6,03 nW
    out parado em ALTO (1,6243 V) : 0,2443 pA -> 0,440 pW -> 0,007%
    Limiar pre-registrado: 33 pA / 60 pW / 1%. Passa por ~135x.
    O pico de 2,90 uA na transicao existe mas so e atravessado: out cruza a j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
2026-09-07 Corrige a linha da etapa 1 no §2 e pre-registra a previsao da fuga em mem
    CORRECAO DE REGISTRO: a linha da etapa 1 no §2 ainda dizia 'Pulso reprova:
    88,84% contra o minimo de 90%'. Esse criterio foi revogado em fa20a70 por ser
    arbitrario, e o criterio funcional que o substituiu foi aprovado pelo
    experimento do receptor. A linha agora diz que o pulso PASSA no criterio
    funcional, com as margens e a estatica medidas, e registra explicitamente que o
    circuito nunca esteve errado — o criterio estava. Etapa mantida como EM
    ANDAMENTO, nao concluida, com os tres criterios de saida que faltam listados:
    fuga em mem, janela de histerese, varredura de Cmem.
    PRE-REGISTRO da previsao da fuga (resultad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
2026-09-07 Fuga em mem medida: os 25,3 fA nao se confirmam, e o sinal liquido e oposto
    Pergunta: a fuga no no mem, medida diretamente, confirma os 25,3 fA inferidos?
    Resposta: NAO. E a discordancia e mais informativa que um desvio de valor.
    A FUGA NAO E UM NUMERO. Medida por ponto de operacao DC (CLAUDE.md §7), com o
    circuito completo e mem forcado:
    mem = -0,127 V -> 3 719,7 fA ENTRANDO em mem (injecao)
    mem = 0,000 V -> -0,000 fA (zero exato, como previsto)
    mem = 0,100 V -> 55,4 fA saindo
    mem = 0,400 V -> 62,1 fA saindo
    disparo DC entre 0,450 e 0,455 V
    Patamar de 55,4 a 62,1 fA, variacao de so 1,12x. A forma segue exatamente o
    fator (1 - exp(-Vds/VT)) previsto, com metade do pat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
2026-09-07 Divide a pendencia 15, registra a raiz, e pre-registra a janela de histerese
    REGISTRO:
    - Pendencia 15 dividida por peso. 15a latch-up: risco BAIXO. Os 3,7 pA estao ~9
    ordens de grandeza abaixo do necessario para acionar a estrutura parasita;
    vigiar na etapa 3, porque a injecao e conducao direta de juncao e cresce com a
    temperatura mais rapido que a fuga sub-limiar. 15b acoplamento por substrato
    entre neuronios vizinhos: risco ALTO, por um motivo especifico deste projeto —
    o sinal tambem e da ordem de pA, entao diafonia de pA nao e ruido somado a
    sinal grande, e sinal inteiro chegando ao vizinho errado. Mitigacao e anel de
    guarda na etapa 8, e isso custa area, o que amarra a p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
2026-09-07 Janela de histerese medida: nao explica a curvatura; o fator 1,76x esta fechado
    Pergunta com duas funcoes. (1) A janela varia com Iin o bastante para explicar a
    curvatura da f-I? NAO. (2) O fator 1,76x da etapa 0 sobrevive ao PDK? SIM, e
    agora esta medido: 2,46x.
    A JANELA, medida da forma de onda (nao inferida):
    1 pA: disparo 0,54976 V, fundo -0,12806 V, janela 0,677818 V
    10 pA: disparo 0,55118 V, fundo -0,12807 V, janela 0,679244 V
    100 pA: disparo 0,56046 V, fundo -0,12786 V, janela 0,688321 V
    O fundo e fixo: 0,16% de variacao sobre 100x de corrente, porque e fixado pelo
    degrau de Cfb. So o topo se move, 1,9%.
    RESPOSTA: variacao de -0,210% em 1 pA contra os +4,15% necessarios. Vi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
2026-09-07 Registra curvatura como aberta nao bloqueante, Ctot medido, e pre-registra Cmem
    REGISTROS:
    1. Hipotese da curvatura CORRIGIDA. Os -2,53% nao podem estar dentro da barra de
    erro do ajuste da f-I porque nao sao residuo de regressao: sao a razao entre
    duas frequencias medidas diretamente, cada uma com CV do ISI ~0,005% e
    convergencia de 0,000% sobre 16x de tstep. A incerteza da razao e ~0,01% e o
    efeito e ~250x isso. Calcular a barra de erro do ajuste segue valendo como
    escrituracao, mas nao dissolve o numero.
    2. Curvatura classificada como ressalva ABERTA e NAO BLOQUEANTE: 2,5% no ponto
    extremo e menos usado da faixa, nao e criterio de saida de etapa nenhuma.
    Registrado co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
2026-09-07 Varredura de Cmem no sky130: o achado central NAO sobrevive. Etapa 1 concluida
    Pergunta: o achado central — Cmem nao controla a frequencia — sobrevive ao PDK?
    RESPOSTA: NAO. No regime em que o circuito funciona, Cmem CONTROLA a frequencia:
    3,39x sobre 8x de Cmem, contra 1,26x do nivel 1 no mesmo intervalo. Venceu o
    Modelo A pre-registrado, que era o modelo que matava o achado.
    MEDIDO (tt, 27 C, IB1=10 nA, IB2=3 uA, Iin=10 pA):
    25fF: 290,33 Hz | CV 0,0007% | exc 1,0245 V | pulso 1,7965 V
    50fF: 211,22 Hz | CV 0,0017% | exc 0,8510 V | pulso 1,7795 V
    100fF: 139,58 Hz | CV 0,0005% | exc 0,6930 V | pulso 1,5992 V
    200fF: 85,58 Hz | CV 0,0050% | exc 0,5781 V | pulso 1,0077 V
    400fF: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
2026-09-08 Registra o mecanismo da inversao, quantifica, e abre o registro de riscos novos
    1. MECANISMO DA INVERSAO no §3, e ele fecha a historia. O cancelamento exigia
    que a janela fosse VDD*Cfb/Ctot e portanto encolhesse junto com Ctot. A janela
    medida e 0,679 V contra 0,278 V do divisor — fator 2,45x. O chute capacitivo e
    so 41% da janela; os outros 59% sao a distancia entre o limiar de comutacao e
    o fundo do undershoot, que sao tensoes ABSOLUTAS e nao encolhem com Ctot. Dai
    o cancelamento evaporar, e dai ele depender do modelo: no nivel 1 o Vth menor
    deixava o termo do divisor dominar.
    Nota de metodo registrada: minha previsao de que seria geometrico era
    razoavel, e a med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
2026-09-08 Preserva o dossie como v1.0, adota o plano de etapas v2.0, e audita o etapas.md
    1. docs/dossie.pdf -> docs/dossie_v1.0.pdf via git mv, historico preservado. NAO
    removido: e o registro do que se acreditava em setembro de 2026, e metade do
    valor do projeto esta em poder comparar o que se pensava com o que se mediu.
    2. docs/etapas.md ja estava no destino.
    3. AUDITORIA do etapas.md contra resultados/ e CLAUDE.md. Sete discrepancias,
    NENHUMA corrigida em silencio — reportadas ao autor. Da mais grave para a
    menos:
    a) A tabela de abertura compara CIRCUITOS DIFERENTES. "158 -> 139,58 Hz" e
    "17,5 -> 13,89 Hz/pA" poem o circuito original do nivel 1 contra o circuito
    COM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
2026-09-08 Pre-registra a rodada 1 da etapa 2 (V0-V5) antes de qualquer execucao
    Corrige tres registros: ambiente real da maquina (ngspice 42 instalada em
    prefixo local), o motivo errado do .option scale=1.0u, e o erro do pfet em que
    parei um nivel cedo na cadeia de includes. Registra a assimetria nfactor_slope
    entre pfet e nfet, e que os 11% sao piso e nao estimativa.
    Claude-Session: https://claude.ai/code/session_013bFMamnPm8yJCk46s5Wt3B
2026-09-08 Etapa 2 rodada 1: instrumento validado; set rndseed nao fixa o sorteio
    Cinco previsoes confirmadas, duas refutadas. O motor estatistico do sky130
    sorteia por instancia (100/100, inclusive no array que replica o par
    Mbp2/Mref2 de geometria identica), a magnitude bate com os slopes do PDK a
    1,05-1,07x em sub-limiar, Pelgrom da 1,944 e 1,952 contra 2,000, o controle
    negativo da sigma = 0 exato e a convergencia fecha em 0,0006%.
    Achado que muda o procedimento da rodada 2: os .model com AGAUSS sao
    avaliados na leitura do netlist, entao set rndseed no .control chega tarde e
    o sorteio fica solto. .option seed=N fixa. Sem isso o teste de convergencia
    acusou +4,84% onde o valor real e -0,0006% - fat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
2026-09-08 Registra a lacuna da frente de entrada: nao ha etapa que a projete
    Entre o microfone e o primeiro neuronio existe um subsistema que converte onda
    continua em pulsos. Ele aparece na arquitetura (dossie §5.4) mas nenhuma das dez
    etapas o projeta. E sao dois subsistemas, nao um.
    Para localizacao (nivel alvo do §6.2), detector de inicio em dois canais: cabe na
    etapa 7 como esta. Para novidade aprendida (nivel ambicioso), banco de filtros por
    bandas — uma cocleia de silicio, subsistema do porte do que ja foi feito ate aqui.
    O plano de dez etapas leva ao nivel alvo; o ambicioso precisa de uma etapa que nao
    existe.
    Nao bloqueante e nao deve ser aberto antes da etapa 7 estar de pe. Registrado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
2026-09-08 Higiene: bruto se apaga e o .cir regenera; .git de 236 MB para 3,1 MB
    O §7 sempre disse que bruto nao e' versionado e que o .cir regenera, mas na
    rodada 1 eu comprimi 393 MB em vez de apagar e ensinei dois scripts a ler .gz -
    o que resolve disco pela metade, nao resolve o repositorio, e faz o script
    depender de um arquivo que a convencao diz que nao deve existir.
    Bruto apagado. mc_lib.ensure() passa a executar o netlist quando o .txt falta.
    Verificado: apagados os 393 MB, v5_nominal.cir regenerou e deu 139,5821 Hz,
    identico ao medido.
    E um erro meu: um git add -A stageou os .txt.gz e o git reset seguinte nao
    apagou os blobs. 35 objetos inalcancaveis somando 259 MB, num historico que
    intei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
2026-09-08 Ignora *.zip: o repositorio tem URL e nao viaja mais em arquivo
    neuro.zip (27 MB) estava nao rastreado e nao ignorado — exatamente o que um
    git add -A varreria para dentro. Foi esse o mecanismo que pos 233 MB de blobs
    inalcancaveis no banco de objetos em 2026-09-08.
    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
2026-09-09 Pre-registra a conta de area da sinapse antes de calcular
    A previsao central que quero ser cobrado: razao area_sinapse/area_neuronio de
    0,4x para peso de 4 bits, e queda de 50 a 100x na contagem de neuronios por chip
    com 100 sinapses por neuronio.
    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
2026-09-09 A sinapse e maior que o neuronio: a contagem do projeto contava so neuronios
    Sem simulacao. PDK + LEF publico + aritmetica. Previsoes em dd8c75e, antes de calcular.
    Uma sinapse com peso digital de 4 bits ocupa 1,28 a 3,79x a area de um neuronio.
    Contando sinapses, 10 mm2 comportam 88 a 130 neuronios com S=100 e 4 bits, contra
    os 15-30 mil que as etapas 9 e 10 declaravam contando so neuronios. Fator 150-250x.
    Quem domina nao e' a memoria (latch dlxtp_1 = 15,01 um2/bit, LEF real) e sim o DAC
    que entrega pA CASADOS: 92,59 um2 ativos em 4 bits contra 4,63 em 2 bits, escalando
    como ~4^n. A area de casamento sai do sigma(Vth) medido na etapa 2.
    Minha previsao de 0,4x foi refutada, e o modo de f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
2026-09-09 Nomeia o modulo de perfil de polarizacao (a analogia do DNA)
    Vocabulario, nao decisao nova. O DNA constroi o cerebro uma vez (irreversivel) e
    depois modula o que existe (continuo). No chip: o tapeout constroi, as tensoes de
    polarizacao modulam. A organizacao correta disso e' um modulo externo com conjuntos
    nomeados de valores de polarizacao mais DACs - perfil audio, presenca, associacao.
    E' a soma de duas decisoes que ja existiam e nunca haviam sido postas lado a lado:
    o chip homogeneo com a modalidade virando parametro de configuracao (dossie 5.4) e
    toda polarizacao acessivel externamente (CLAUDE.md 6). O soquete ja estava
    projetado; faltava o nome.
    Registra o LIMITE junto, porque sem ele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
